Shayshez/Wavelet/README.md

# Wavelet
## CC-BY-SA 4.0
Rotatable multimode filter based on MI "Ripples"

## ROTATABLE = Modules for 3u / 1u
Wavelet comes with 2 panels: 1u/20hp and 3u/6hp
