Shayshez/Wavelet/Wavelet5-BOM.xlsx

Qty | Value | Device | Package | Parts | Mouser / Source | Description
4 | 510R | R-US_R0603 | R0603 | R4, R6, R14, R21 | 71-CRCW0603510RFKEAC | RESISTOR, American symbol
6 | 1.0k | R-US_R0603 | R0603 | R9, R11, R16, R17, R25, R35 | 71-CRCW06031K00FKEAC | RESISTOR, American symbol
1 | 3.6k | R-US_R0603 | R0603 | R5 | 71-CRCW06033K60FKEAC | RESISTOR, American symbol
2 | 6.8k | R-US_R0603 | R0603 | R1, R22 | 71-CRCW06036K80FKEAC | RESISTOR, American symbol
2 | 15k | R-US_R0603 | R0603 | R29, R40 | 71-CRCW060315K0FKEAC | RESISTOR, American symbol
3 | 22k | R-US_R0603 | R0603 | R8, R18, R39 | 71-CRCW060322K0FKEAC | RESISTOR, American symbol
1 | 27k | R-US_R0603 | R0603 | R36 | 667-ERJ-3RBD2702V | RESISTOR, American symbol
7 | 33k | R-US_R0603 | R0603 | R2, R3, R7, R13, R19, R20, R23 | 603-AC0603FR-1333KL | RESISTOR, American symbol
2 | 39k | R-US_R0603 | R0603 | R24, R26 | 71-CRCW060339K0FKEAC | RESISTOR, American symbol
4 | 47k | R-US_R0603 | R0603 | R27, R28, R38, R41 | 71-CRCW060347K0JNEAC | RESISTOR, American symbol
1 | 62k | R-US_R0603 | R0603 | R37 | 603-AC0603FR-1362KL | RESISTOR, American symbol
7 | 100k | R-US_R0603 | R0603 | R12, R15, R30, R31, R32, R33, R34 | 71-CRCW0603100KFKEAC | RESISTOR, American symbol
1 | 300k | R-US_R0603 | R0603 | R10 | 603-RC0603FR-07300KL | RESISTOR, American symbol
2 | 47p | C-USC0603 | C0603 C0G/NP0 | C22, C25 | 80-C0603C470J5GAC | CAPACITOR, American symbol
4 | 220p | C-USC0603 | C0603 C0G/NP0 Tol < 2% | C14, C16, C17, C20 | 77-VJ0603A221GXACBC | CAPACITOR, American symbol
7 | 560p | C-USC0603 | C0603 C0G/NP0 | C13, C15, C18, C21, C23, C28, C30 | 77-VJ0603A561GXACBC | CAPACITOR, American symbol
12 | 100n | C-USC0603 | C0603 | C2, C4, C7, C8, C9, C10, C11, C12, C24, C26, C27, C29 | 603-CC603KRX7R9BB104 | CAPACITOR, American symbol
2 | 220n | C-USC0603 | C0603 | C3, C19 | 603-CC0603JRX79BB224 | CAPACITOR, American symbol
1 | 4.7u | CPOL-USB Non Polarized! | PANASONIC_B -NP- | C6 | 647-UWP1C4R7MCL | POLARIZED CAPACITOR, American symbol
2 | 47u | CPOL-USD | PANASONIC_D | C1, C5 | 667-EEE-FK1V470P | POLARIZED CAPACITOR, American symbol
2 | 1N4148 | DIODE-SOD323-W | SOD323-W | D3, D4 | 512-1N4148WS | DIODE
2 | 1N5819HW | DIODE-SOD123 | SOD123 | D1, D2 | 621-1N5819HW-F | DIODE
1 | LED-RGB-CA-HEBEI | LED-RGB-CA-HEBEI | PLCC4 | RGB_LED | 604-AAA3528LSEEZGKQB | Hebei I.T. (Shanghai) PLCC4RGBCT-CA
1 | LM13700M | LM13700M | SO16 | IC4 | 926-LM13700M/NOPB | Dual OTA with buffers
1 | LM4040 5.0V | LM4041C12DBZ | DBZ_R-PDSO-G3 | IC1 | 595-LM4040C50IDBZR | PRECISION MICROPOWER SHUNT VOLTAGE REFERENCE
2 | MMBT3906 | MMBT3906LT1-PNP-SOT23-BEC | SOT23-BEC | Q1, Q2 | 863-MMBT3906TT1G | PNP Transistror
2 | PTCSMD | PTCSMD | PTC-1206 | P1, P2 | 576-1206L035/16YR | Resettable Fuse PTC
5 | TL072D | TL072D | SO08 | IC2, IC3, IC6, IC7, IC8 | 595-TL072CD | OP AMP
1 | V2164 | SSM2164S | SOIC16N | IC5 | https://www.thonk.co.uk/shop/coolaudio-v2164-all/ | SMD!!
6 | THONKICONN | THONKICONN | PJ301_WQP_PJ_301M6 | FM_CV, FREQ_CV, GAIN_CV, INPUT, OUTPUT, RES_CV | https://www.thonk.co.uk/shop/thonkiconn/
1 | POWER_SIMPLE | POWER_SIMPLE | 2X05_SMT_HEADER | POWER! | https://www.ebay.com/itm/10pcs-2-40Pin-SMD-SMT-2-40Pin-Male-Double-Row-Pin-Header-Connector-2-54MM-Pitch/182570982083
1 | 5k | R-TRIMM3296X | RTRIM3296X | TRIM1 | 652-3296Y-1-502LF | Trimm resistor
3 | 10kB | POT_USVERTICAL_PS | ALPS_POT_VERTICAL_PS | CUTOFF, FM, RESONANCE | https://www.thonk.co.uk/shop/alpha-9mm-pots-dshaft/
3 | Knobs that fits your pots…
1 | APEM-MHS233K | APEM-MHS233K | APEM-MHS233K | FILTER_TYPE | 642-MHS233K
 | Mouser Cart: | https://www.mouser.com/ProjectManager/ProjectDetail.aspx?AccessID=751e21de3c
