Shayshez/Wavelet/wavelet7.brd

## EAGLE design wavelet7.brd (2018-11-22)

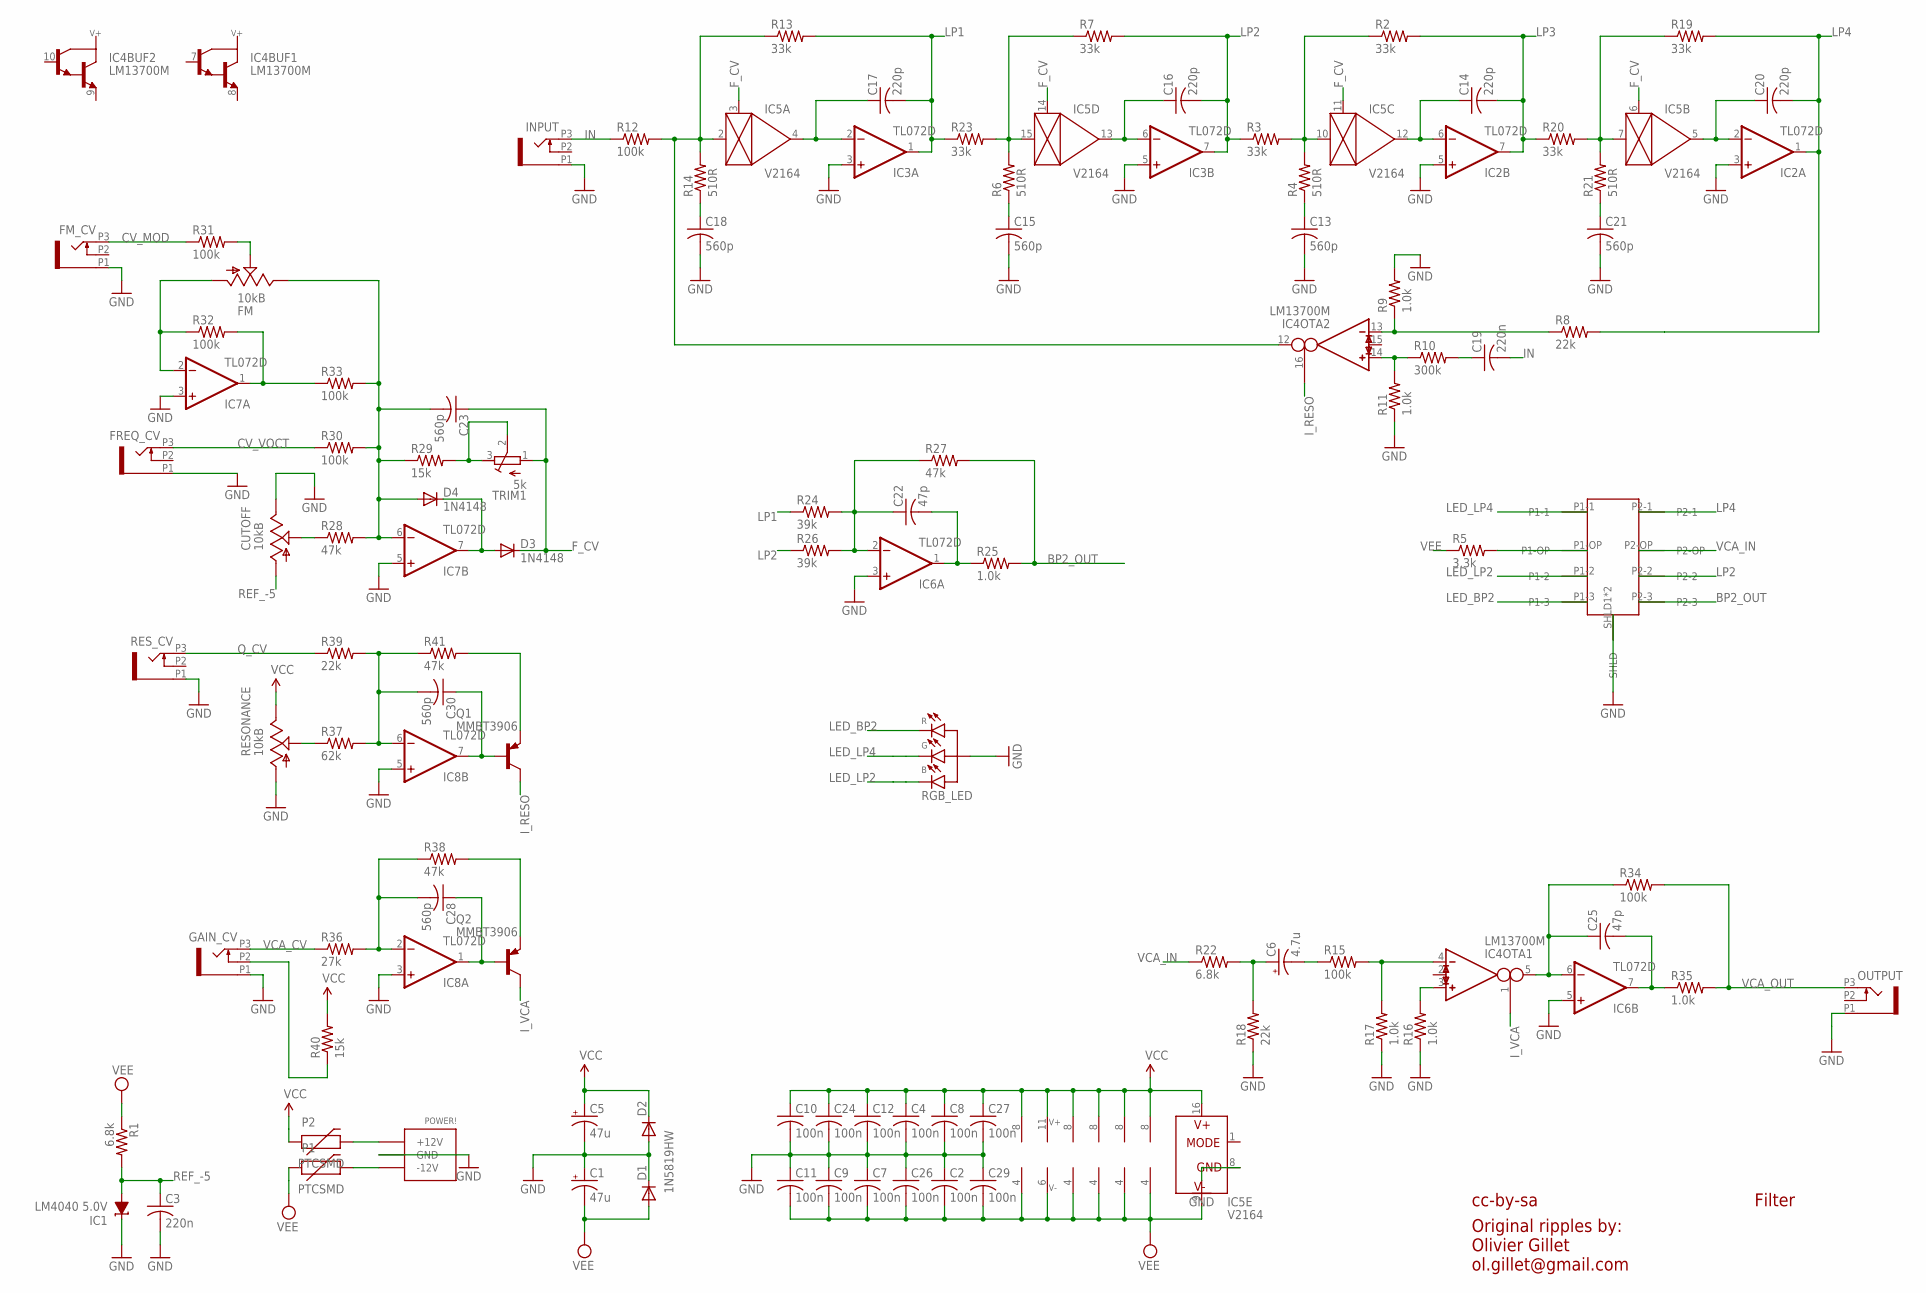
[picture p1: schematic wavelet7.sch]

Parts:
C1, C5: 47u; PANASONIC_D
C2, C4, C7, C8, C9, C10, C11, C12, C24, C26, C27, C29: 100n; C0603
C3, C19: 220n; C0603
C6: 4.7u; PANASONIC_B
C13, C15, C18, C21, C23, C28, C30: 560p; C0603
C14, C16, C17, C20: 220p; C0603
C22, C25: 47p; C0603
CUTOFF: 10kB; ALPS_POT_VERTICAL_PS
D1, D2: 1N5819HW; SOD123
D3, D4: 1N4148; SOD323-W
FILTER_MODE: APEM-MHS233K
FM: 10kB; ALPS_POT_VERTICAL_PS
FM_CV: OG-PJ301_PJ301_THONKICONN; OG-PJ301_WQP_PJ_301M6_NO_HOLE
FREQ_CV: OG-PJ301_PJ301_THONKICONN; OG-PJ301_WQP_PJ_301M6_NO_HOLE
GAIN_CV: OG-PJ301_PJ301_THONKICONN; OG-PJ301_WQP_PJ_301M6_NO_HOLE
IC1: LM4040 5.0V; DBZ_R-PDSO-G3
IC2, IC3, IC6, IC7, IC8: TL072D; SO08
IC4: LM13700M; SO16
IC5: V2164; SOIC16N
INPUT: OG-PJ301_PJ301_THONKICONN; OG-PJ301_WQP_PJ_301M6_NO_HOLE
OUTPUT: OG-PJ301_PJ301_THONKICONN; OG-PJ301_WQP_PJ_301M6_NO_HOLE
P1, P2: PTCSMD; PTC-1206
POWER!: POWER_SIMPLE; 2X05_SMT_HEADER
Q1, Q2: MMBT3906; SOT23-BEC
R1, R22: 6.8k; R0603
R2, R3, R7, R13, R19, R20, R23: 33k; R0603
R4, R6, R14, R21: 510R; R0603
R5: 3.3k; R0603
R8, R18, R39: 22k; R0603
R9, R11, R16, R17, R25, R35: 1.0k; R0603
R10: 300k; R0603
R12, R15, R30, R31, R32, R33, R34: 100k; R0603
R24, R26: 39k; R0603
R27, R28, R38, R41: 47k; R0603
R29, R40: 15k; R0603
R36: 27k; R0603
R37: 62k; R0603
RESONANCE: 10kB; ALPS_POT_VERTICAL_PS
RES_CV: OG-PJ301_PJ301_THONKICONN; OG-PJ301_WQP_PJ_301M6_NO_HOLE
RGB_LED: LED-RGB-CA-HEBEI; PLCC4
TRIM1: 5k; RTRIM3296X

Connections:
BP2_OUT: FILTER_MODE.P2-3, R25.2, R27.2
CV_F_POT: CUTOFF.P$2 (S), R28.1
CV_MOD: FM_CV.P3 (3), R31.1
CV_VOCT: FREQ_CV.P3 (3), R30.1
F_CV: C23.1, D3.C, IC5.3 (CTRL), IC5.6 (CTRL), IC5.11 (CTRL), IC5.14 (CTRL), TRIM1.1 (E)
GND: C1.+, C2.1, C3.2, C4.2, C5.-, C7.1, C8.2, C9.1, C10.2, C11.1, C12.2, C13.2, C15.2, C18.2, C21.2, C24.2, C26.1, C27.2, C29.1, CUTOFF.P$1 (E), D1.C, D2.A, FILTER_MODE.SHLD1 (SHLD), FILTER_MODE.SHLD2 (SHLD), FM_CV.P1 (1), FREQ_CV.P1 (1), GAIN_CV.P1 (1), IC1.1 (C), IC2.3 (+IN), IC2.5 (+IN), IC3.3 (+IN), IC3.5 (+IN), IC5.8 (GND), IC6.3 (+IN), IC6.5 (+IN), IC7.3 (+IN), IC7.5 (+IN), IC8.3 (+IN), IC8.5 (+IN), INPUT.P1 (1), OUTPUT.P1 (1), POWER!.3 (GND), POWER!.4 (GND), POWER!.5 (GND), POWER!.6 (GND), POWER!.7 (GND), POWER!.8 (GND), R9.2, R11.1, R16.1, R17.1, R18.1, RESONANCE.P$3 (A), RES_CV.P1 (1), RGB_LED.P$2 (A)
IN: C19.2, INPUT.P3 (3), R12.1
I_RESO: IC4.16 (I_BIAS), Q1.C
I_VCA: IC4.1 (I_BIAS), Q2.C
LED_BP2: FILTER_MODE.P1-3, RGB_LED.P$1 (CR)
LED_LP2: FILTER_MODE.P1-2, RGB_LED.P$3 (CB)
LED_LP4: FILTER_MODE.P1-1, RGB_LED.P$4 (CG)
LP1: C17.2, IC3.1 (OUT), R13.2, R23.1, R24.1
LP2: C16.2, FILTER_MODE.P2-2, IC3.7 (OUT), R3.1, R7.2, R26.1
LP3: C14.2, IC2.7 (OUT), R2.2, R20.1
LP4: C20.2, FILTER_MODE.P2-1, IC2.1 (OUT), R8.2, R19.2
unnamed: IC7.1 (OUT), R32.2, R33.1
unnamed: C17.1, IC3.2 (-IN), IC5.4 (OUT)
unnamed: IC5.15 (IN), R6.2, R7.1, R23.2
unnamed: R29.2, TRIM1.2 (S), TRIM1.3 (A)
unnamed: IC4.3 (IN_P), R16.2
unnamed: P2.2, POWER!.9 (+12V), POWER!.10 (+12V)
unnamed: C19.1, R10.2
unnamed: C18.1, R14.1
unnamed: C16.1, IC3.6 (-IN), IC5.13 (OUT)
unnamed: IC4.12 (OUT), IC5.2 (IN), R12.2, R13.1, R14.2
unnamed: C15.1, R6.1
unnamed: IC5.10 (IN), R2.1, R3.2, R4.2
unnamed: C14.1, IC2.6 (-IN), IC5.12 (OUT)
unnamed: IC4.13 (IN_N), R8.1, R9.1
unnamed: C13.1, R4.1
unnamed: IC5.7 (IN), R19.1, R20.2, R21.2
unnamed: C20.1, IC2.2 (-IN), IC5.5 (OUT)
unnamed: IC4.14 (IN_P), R10.1, R11.2
unnamed: C21.1, R21.1
unnamed: P1.2, POWER!.1 (-12V), POWER!.2 (-12V)
unnamed: FM.P$2 (S), R31.2
unnamed: FM.P$3 (A), IC7.2 (-IN), R32.1
unnamed: C23.2, D4.A, FM.P$1 (E), IC7.6 (-IN), R28.2, R29.1, R30.2, R33.2
unnamed: R37.1, RESONANCE.P$2 (S)
unnamed: C28.2, IC8.2 (-IN), R36.2, R38.1
unnamed: C30.2, IC8.6 (-IN), R37.2, R39.2, R41.1
unnamed: C30.1, IC8.7 (OUT), Q1.B
unnamed: Q1.E, R41.2
unnamed: GAIN_CV.P2 (2), R40.1
unnamed: C28.1, IC8.1 (OUT), Q2.B
unnamed: Q2.E, R38.2
unnamed: C6.+, R18.2, R22.2
unnamed: FILTER_MODE.P1-OP, R5.2
unnamed: D3.A, D4.C, IC7.7 (OUT)
unnamed: C22.1, IC6.2 (-IN), R24.2, R26.2, R27.1
unnamed: C22.2, IC6.1 (OUT), R25.1
unnamed: IC4.4 (IN_N), R15.2, R17.2
unnamed: C25.1, IC4.5 (OUT), IC6.6 (-IN), R34.1
unnamed: C25.2, IC6.7 (OUT), R35.1
unnamed: C6.-, R15.1
Q_CV: R39.1, RES_CV.P3 (3)
REF_-5: C3.1, CUTOFF.P$3 (A), IC1.2 (A), R1.2
VCA_CV: GAIN_CV.P3 (3), R36.1
VCA_IN: FILTER_MODE.P2-OP, R22.1
VCA_OUT: OUTPUT.P3 (3), R34.2, R35.2
VCC: C4.1, C5.+, C8.1, C10.1, C12.1, C24.1, C27.1, D2.C, IC2.8 (V+), IC3.8 (V+), IC4.11 (V+), IC5.16 (V+), IC6.8 (V+), IC7.8 (V+), IC8.8 (V+), P2.1, R40.2, RESONANCE.P$1 (E)
VEE: C1.-, C2.2, C7.2, C9.2, C11.2, C26.2, C29.2, D1.A, IC2.4 (V-), IC3.4 (V-), IC4.6 (V-), IC5.9 (V-), IC6.4 (V-), IC7.4 (V-), IC8.4 (V-), P1.1, R1.1, R5.1

Notes on the sheet:
cc-by-sa
Olivier Gillet
ol.gillet@gmail.com
Filter
Original ripples by:

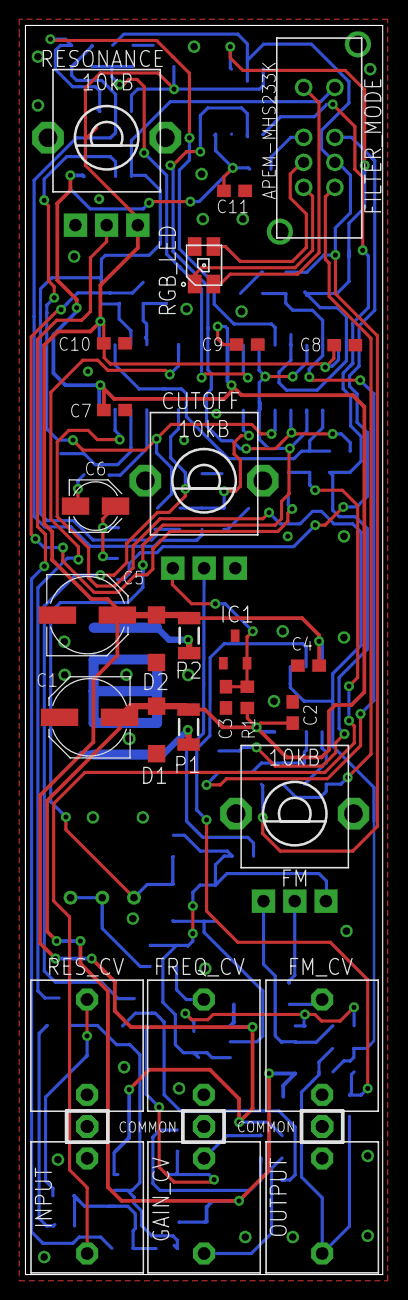
[picture p2: board wavelet7.brd from above]

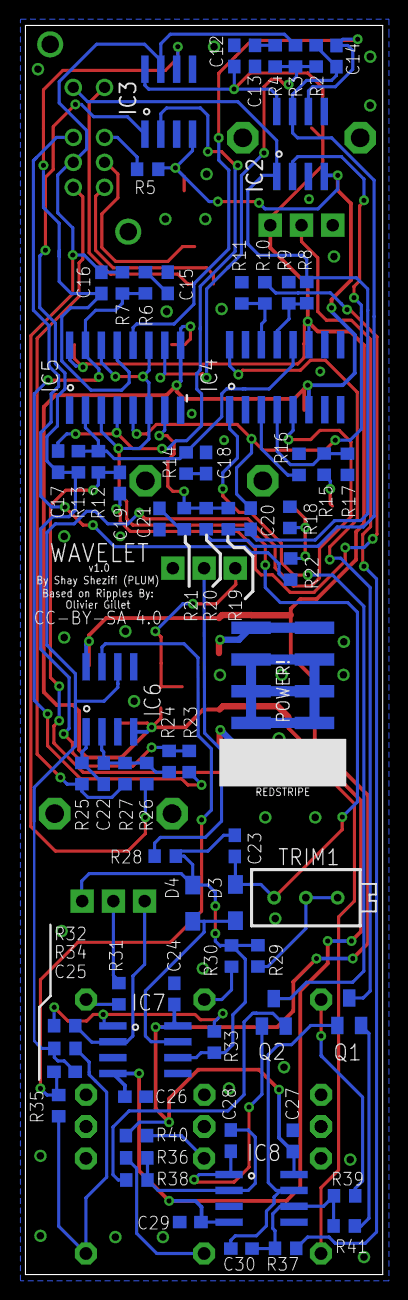
[picture p3: board wavelet7.brd from below]

Board: 2 copper layers, 28.6 x 100.0 mm, 100 parts (72 on the bottom side), 63 nets.
