Shayshez/Wavelet/(threads)

Thread 1 (2019-06-20):

Mouser Project issues

infovore, 2019-06-20:
Just a few notes with regards to the Mouser Project / BOM:

* the 1N4148 diodes are missing from the Mouser Project
* the transistors on the Mouser project are SC-75-3 / SOT-416 packages, which are far smaller than the SOT-223 packages on the board
